Oskari-Tuormaa/guitar-hero-mod/world-tour-guitar-HID-descriptor.md

# Intro

This is a document describing which physical buttons are mapped to which usages.

# Mappings

**Frets**
- Green ....... B0
- Red ......... B1
- Yellow ...... B2
- Blue ........ B3
- Orange ...... B4

**D-pad**
- Left ........ B14 & B17
- Right ....... B15 & B18
- Down ........ B13 & B20
- Up .......... B12 & B19

**Misc**
- Strum up .... B14 & B17
- Strum down .. B15 & B18
- Star power .. B8
- Start ....... B9

**Continous**
- Slide bar ... AXIS 0
- Whammy ...... AXIS 2

**Accelerometer**
- X ........... AXIS 3
- Y ........... AXIS 4
- Z ........... AXIS 5

# Accelerometer

The convention I will be using for the accelerometer axes, is as follows:

    Imagine holding the guitar in front of you, with the wide face of the
    guitar containing the strum bar facing you and the fret board pointing to
    the left. In this case the positive X axis is to the left, the positive
    Y axis is away from you and the positive Z axis is up.
