Oskari-Tuormaa/guitar-hero-mod/schematics/motherboard/motherboard.kicad_pcb

## KiCad design schematics/motherboard/motherboard.kicad_pcb (2025-04-10)

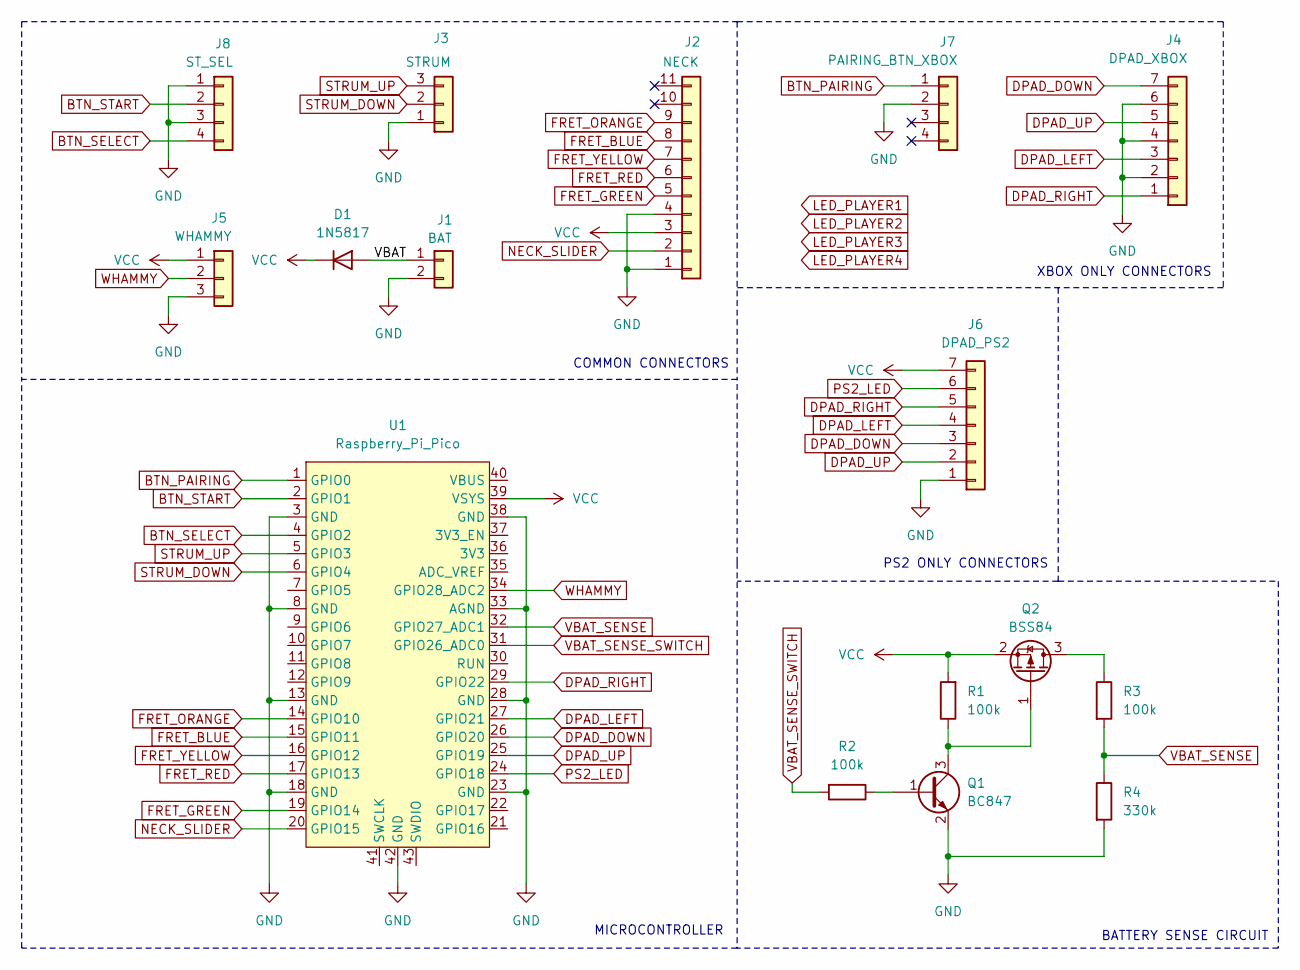
[picture p1: schematic motherboard.kicad_sch]

Parts:
D1: 1N5817; D_DO-41_SOD81_P7.62mm_Horizontal
J1: BAT; PinHeader_1x02_P2.00mm_Vertical
J2: NECK; PinHeader_1x11_P2.00mm_Vertical
J3: STRUM; PinHeader_1x03_P2.00mm_Vertical
J4: DPAD_XBOX; PinHeader_1x07_P2.00mm_Vertical
J5: WHAMMY; PinHeader_1x03_P2.00mm_Vertical
J6: DPAD_PS2; PinHeader_1x07_P2.00mm_Vertical
J7: PAIRING_BTN_XBOX; PinHeader_1x04_P2.00mm_Vertical
J8: ST_SEL; PinHeader_1x04_P2.00mm_Vertical
Q1: BC847; SOT-23
Q2: BSS84; SOT-23
R1, R2, R3: 100k; R_1206_3216Metric
R4: 330k; R_1206_3216Metric
U1: Raspberry_Pi_Pico

Connections:
/VBAT: D1.2 (A), J1.1
BTN_PAIRING: J7.1, U1.1 (GPIO0)
BTN_SELECT: J8.4, U1.4 (GPIO2)
BTN_START: J8.2, U1.2 (GPIO1)
DPAD_DOWN: J4.7, J6.3, U1.26 (GPIO20)
DPAD_LEFT: J4.3, J6.4, U1.27 (GPIO21)
DPAD_RIGHT: J4.1, J6.5, U1.29 (GPIO22)
DPAD_UP: J4.5, J6.2, U1.25 (GPIO19)
FRET_BLUE: J2.8, U1.15 (GPIO11)
FRET_GREEN: J2.5, U1.19 (GPIO14)
FRET_ORANGE: J2.9, U1.14 (GPIO10)
FRET_RED: J2.6, U1.17 (GPIO13)
FRET_YELLOW: J2.7, U1.16 (GPIO12)
GND: J1.2, J2.1, J2.4, J3.1, J4.2, J4.4, J4.6, J5.3, J6.1, J7.2, J8.1, J8.3, Q1.2 (E), R4.2, U1.3 (GND), U1.8 (GND), U1.13 (GND), U1.18 (GND), U1.23 (GND), U1.28 (GND), U1.33 (AGND), U1.38 (GND), U1.42 (GND)
NECK_SLIDER: J2.2, U1.20 (GPIO15)
unnamed: Q1.1 (B), R2.1
unnamed: Q1.3 (C), Q2.1 (G), R1.1
unnamed: Q2.3 (D), R3.1
PS2_LED: J6.6, U1.24 (GPIO18)
STRUM_DOWN: J3.2, U1.6 (GPIO4)
STRUM_UP: J3.3, U1.5 (GPIO3)
VBAT_SENSE: R3.2, R4.1, U1.32 (GPIO27_ADC1)
VBAT_SENSE_SWITCH: R2.2, U1.31 (GPIO26_ADC0)
VCC: D1.1 (K), J2.3, J5.1, J6.7, Q2.2 (S), R1.2, U1.39 (VSYS)
WHAMMY: J5.2, U1.34 (GPIO28_ADC2)

Notes on the sheet:
BATTERY SENSE CIRCUIT
COMMON CONNECTORS
MICROCONTROLLER
XBOX ONLY CONNECTORS
PS2 ONLY CONNECTORS

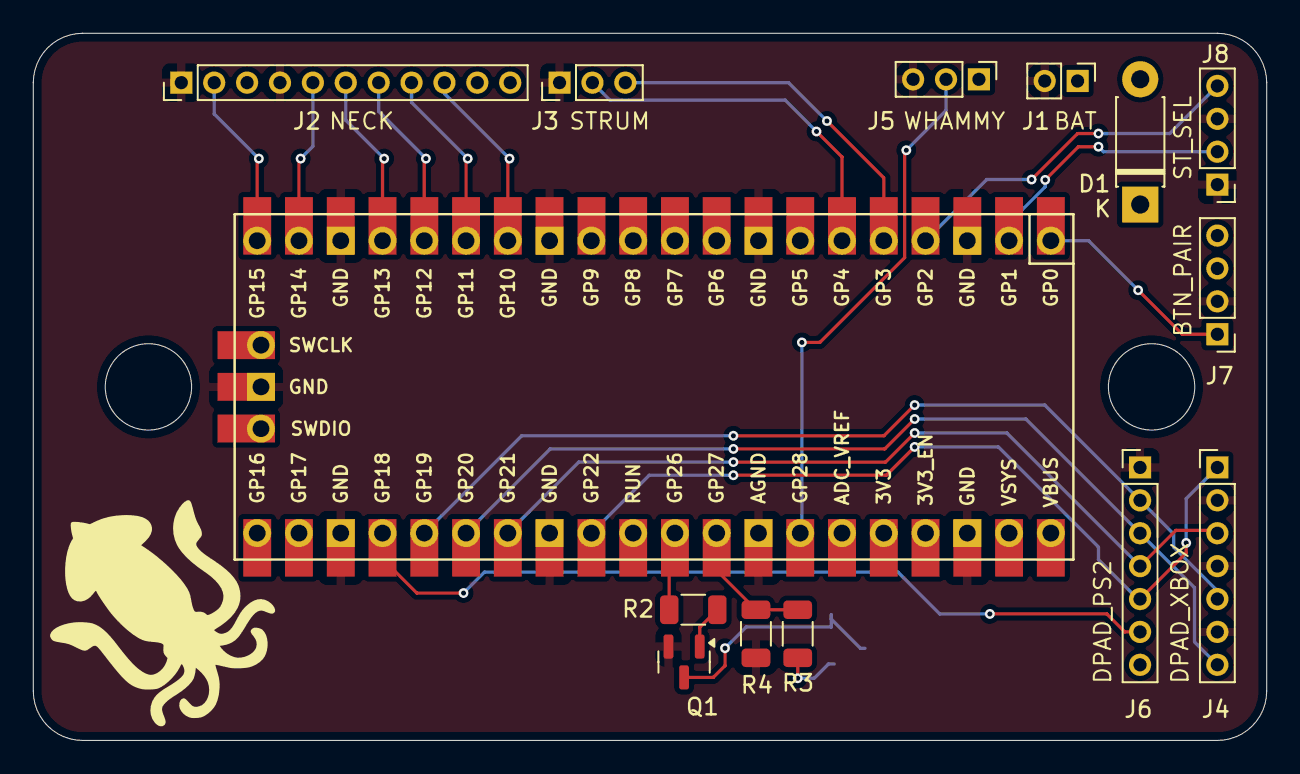
[picture p2: board motherboard.kicad_pcb from above]

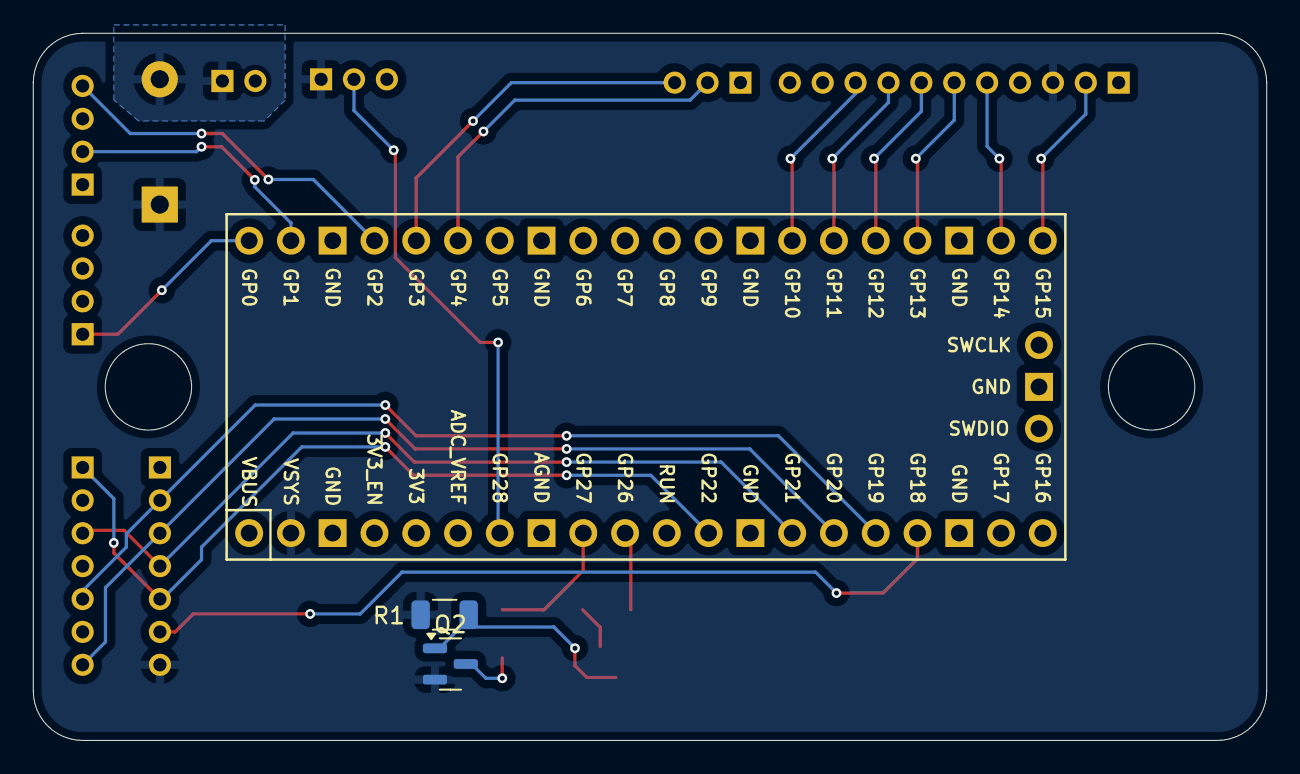
[picture p3: board motherboard.kicad_pcb from below]

Board: 2 copper layers, 75.0 x 43.0 mm, 16 parts (2 on the bottom side), 25 nets.
