Oskari-Tuormaa/guitar-hero-mod/schematics/strum_bar/strum_bar.kicad_pcb

## KiCad design schematics/strum_bar/strum_bar.kicad_pcb (2024-09-09)

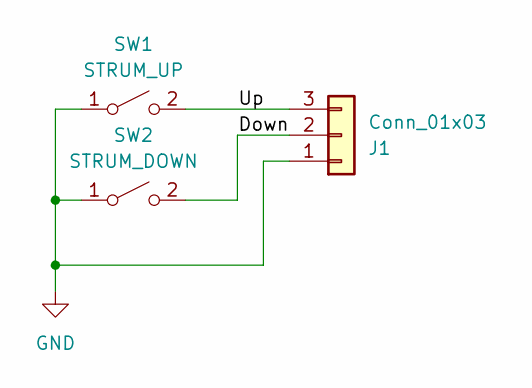
[picture p4: schematic strum_bar.kicad_sch]

Parts:
J1: Conn_01x03; PinHeader_1x03_P2.00mm_Vertical
SW1: STRUM_UP; MX_PCB
SW2: STRUM_DOWN; MX_PCB

Connections:
/Down: J1.2, SW2.2 (B)
/Up: J1.3, SW1.2 (B)
GND: J1.1, SW1.1 (A), SW2.1 (A)

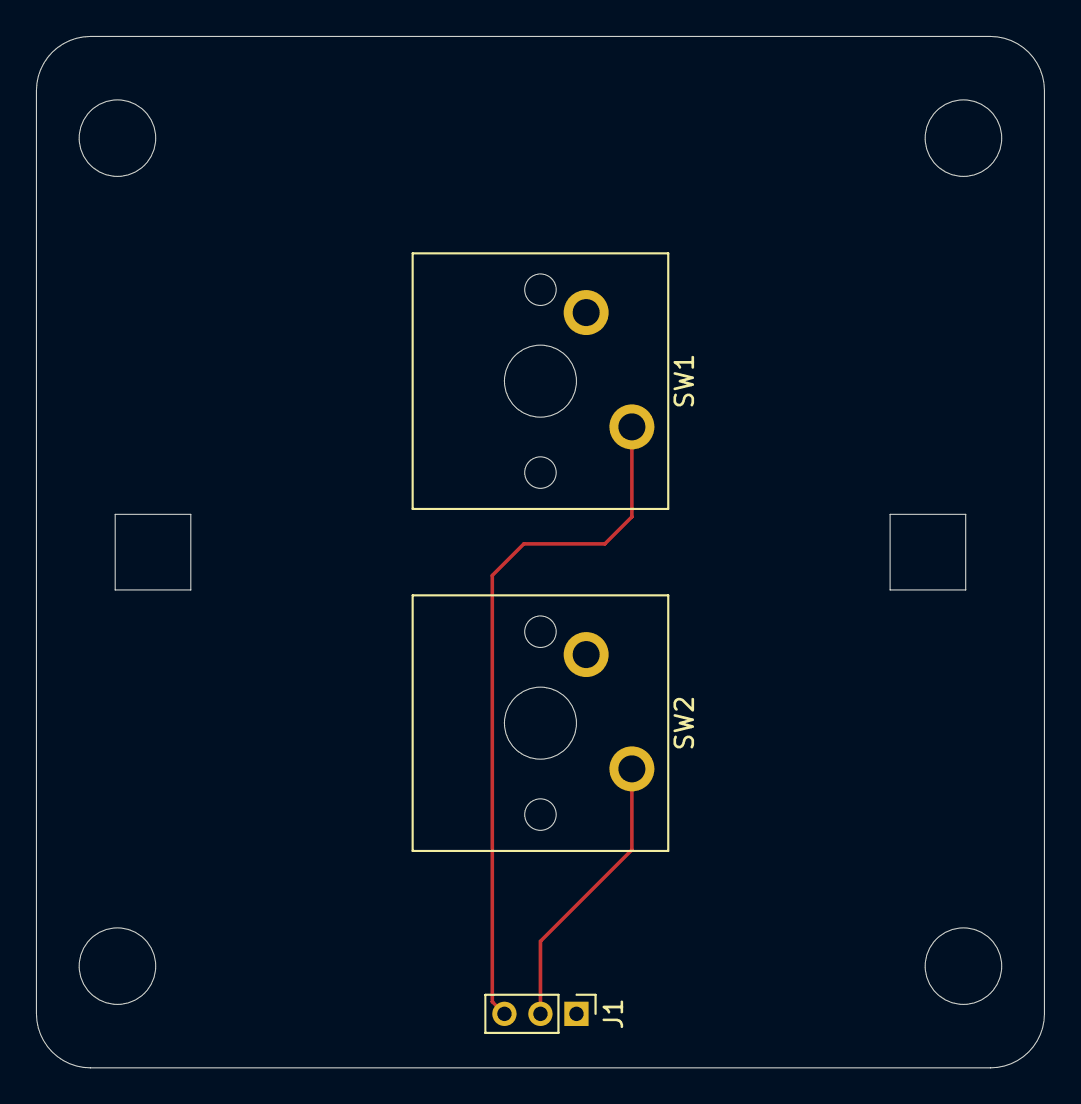
[picture p5: board strum_bar.kicad_pcb from above]

Board: 2 copper layers, 56.0 x 57.3 mm, 3 parts (0 on the bottom side), 3 nets.
