Oskari-Tuormaa/guitar-hero-mod/schematics/fret_board/fret_board.kicad_pcb

## KiCad design schematics/fret_board/fret_board.kicad_pcb (2024-09-09)

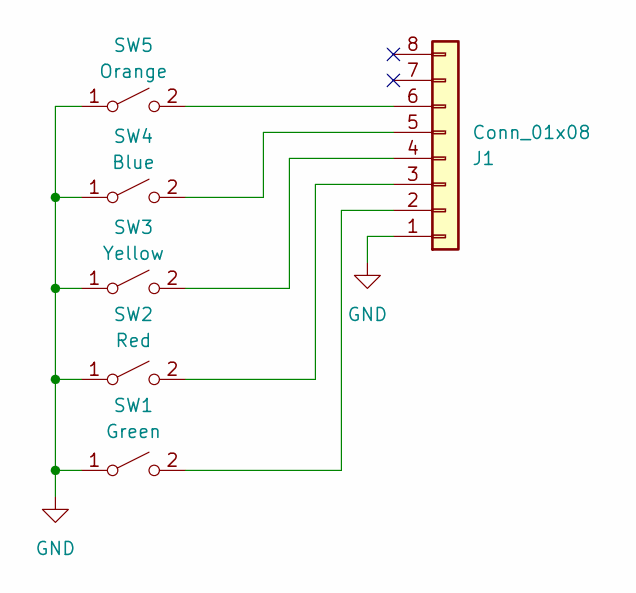
[picture p6: schematic fret_board.kicad_sch]

Parts:
J1: Conn_01x08; PinHeader_1x08_P2.00mm_Vertical
SW1: Green; Choc_V1_sunken
SW2: Red; Choc_V1_sunken
SW3: Yellow; Choc_V1_sunken
SW4: Blue; Choc_V1_sunken
SW5: Orange; Choc_V1_sunken

Connections:
GND: J1.1, SW1.1 (A), SW2.1 (A), SW3.1 (A), SW4.1 (A), SW5.1 (A)
unnamed: J1.2, SW1.2 (B)
unnamed: J1.3, SW2.2 (B)
unnamed: J1.4, SW3.2 (B)
unnamed: J1.5, SW4.2 (B)
unnamed: J1.6, SW5.2 (B)

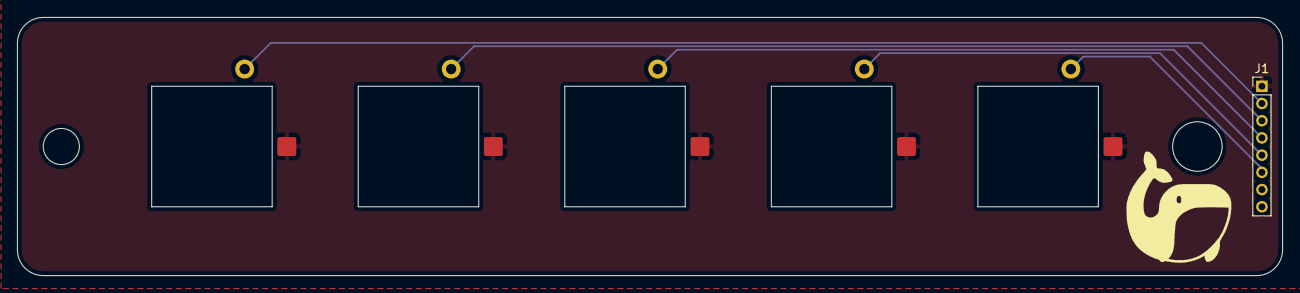
[picture p7: board fret_board.kicad_pcb from above]

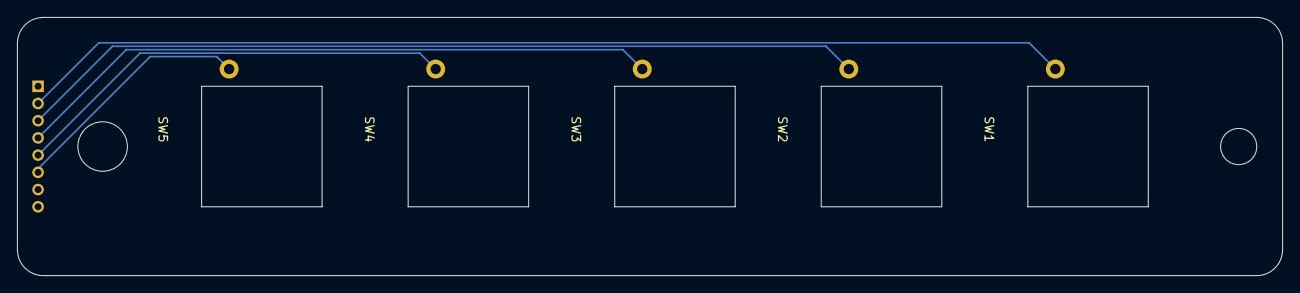
[picture p8: board fret_board.kicad_pcb from below]

Board: 2 copper layers, 147.0 x 30.0 mm, 6 parts (5 on the bottom side), 6 nets.
