Oskari-Tuormaa/guitar-hero-mod/(commit log)

2024-08-17 Add pico-sdk as submodule
2024-08-28 Move pico-sdk to 3rdparty directory
2024-08-28 Add initial fret_board pcb files
    [fret_board.kicad_pcb, fret_board.kicad_sch]
2024-08-28 Added schematic and PCB design to fret_board
    [fret_board.kicad_pcb, fret_board.kicad_sch]
2024-08-28 Flip fret_board connector
    [fret_board.kicad_pcb, fret_board.kicad_sch]
2024-08-28 Add strum_bar kicad file
    [strum_bar.kicad_pcb, strum_bar.kicad_sch]
2024-08-28 Add initial empty motherboard schematic project
    [motherboard.kicad_pcb, motherboard.kicad_sch]
2024-08-29 Fix awkward ground plane
    [fret_board.kicad_pcb]
2024-09-02 Create custom sunken Choc V1 footprint
2024-09-02 Use sunken choc V1 footprint for fretboard
    [fret_board.kicad_pcb, fret_board.kicad_sch]
2024-09-02 Move sunken choc pads closer
    [fret_board.kicad_pcb]
2024-09-06 Update fret_board, motherboard and strum_bar schematics
    [fret_board.kicad_pcb, fret_board.kicad_sch, motherboard.kicad_pcb, motherboard.kicad_sch, strum_bar.kicad_pcb]
2024-09-08 Add more KiCAD stuff to .gitignore
2024-09-08 Add battery sensing circuit and reverse polarity protection diode
    [motherboard.kicad_pcb, motherboard.kicad_sch]
2024-09-09 Ignore kicad Gerber output
2024-09-09 Add silkscreen graphics to each schematic
    [fret_board.kicad_pcb, motherboard.kicad_pcb, motherboard.kicad_sch, strum_bar.kicad_pcb]
2024-11-30 Update pico-sdk to 2.1.0
2025-04-10 Update Q2 to proper footprint and fix wrong R3/R4 silkscreen
    [motherboard.kicad_pcb, motherboard.kicad_sch]
